jktightwad/PagerSystem/enclosure/ball_fit_test/hat_variant1.stl

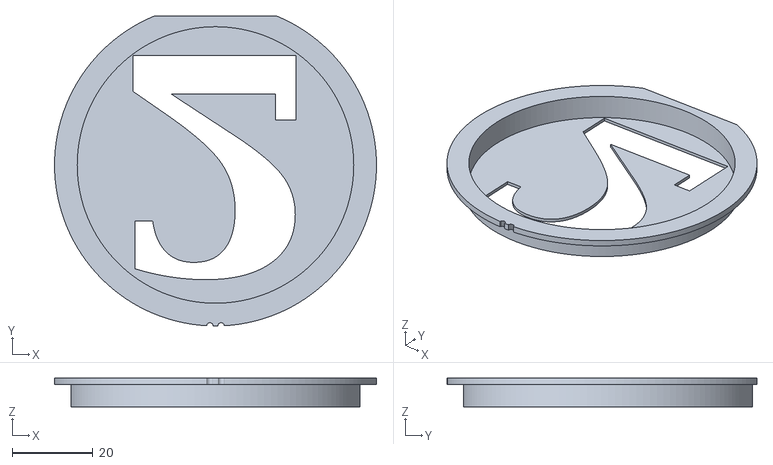
[picture p6: CAD file, 2026-11-08]
enclosure/ball_fit_test/hat_variant1.stl
80.0 x 77.0 x 7.10
