jktightwad/PagerSystem/enclosure/pager_rev2/pogo_test.stl

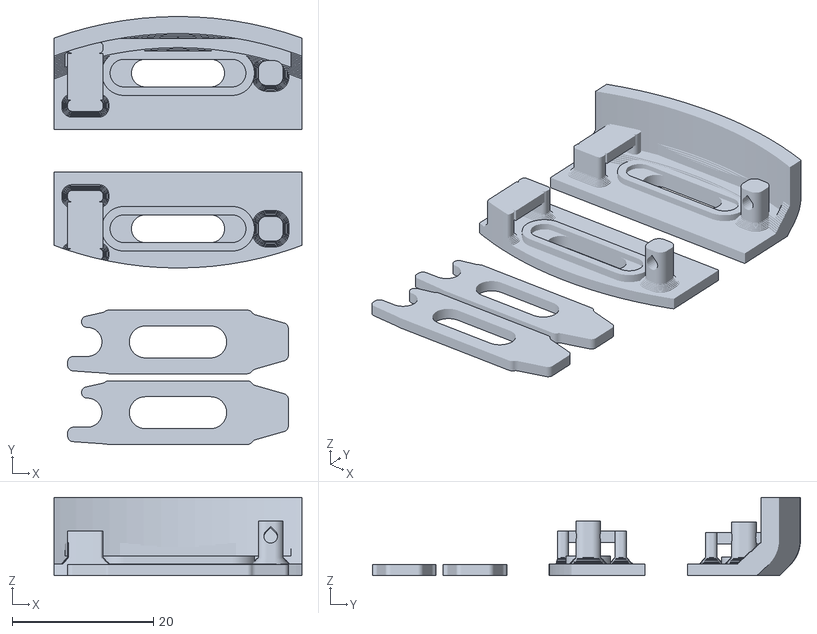
[picture p7: CAD file, 2026-11-14]
enclosure/pager_rev2/pogo_test.stl
35.0 x 60.5 x 11.1
