jktightwad/PagerSystem/enclosure/pager_shell_test/hat.stl

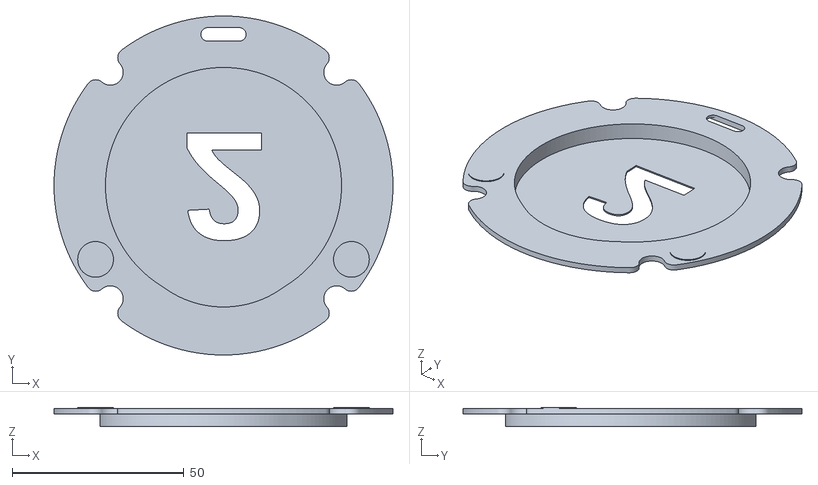
[picture p8: CAD file, 2026-11-13]
enclosure/pager_shell_test/hat.stl
98.7 x 98.7 x 5.55
