jktightwad/PagerSystem/enclosure/pogo_fit_test/pogo_fit_test.stl

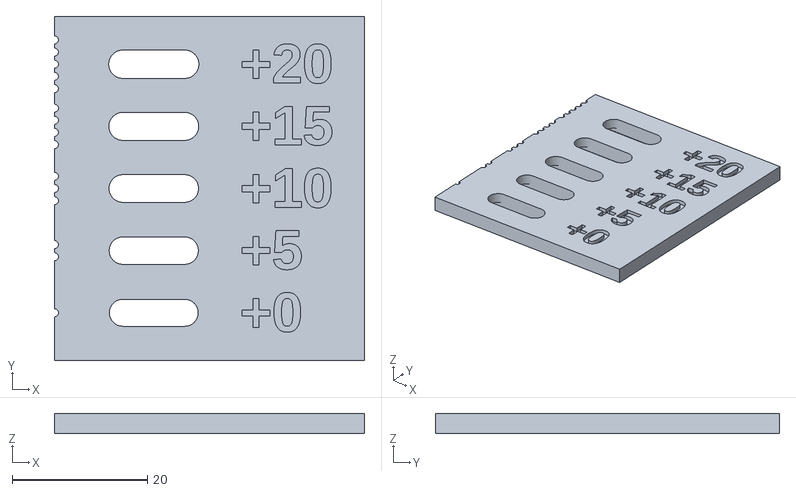
[picture p9: CAD file, 2026-11-09]
enclosure/pogo_fit_test/pogo_fit_test.stl
45.9 x 51.0 x 3.00
