jktightwad/PagerSystem/enclosure/pogo_key_test/pogo_key_top.stl

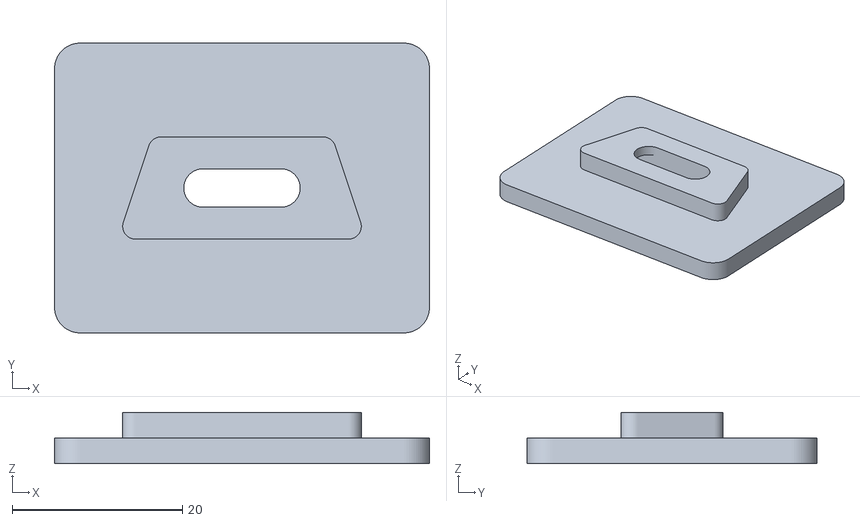
[picture p10: CAD file, 2026-11-08]
enclosure/pogo_key_test/pogo_key_top.stl
44.0 x 34.0 x 6.00
