jktightwad/PagerSystem/enclosure/ring_test/ring_test_spacers.stl

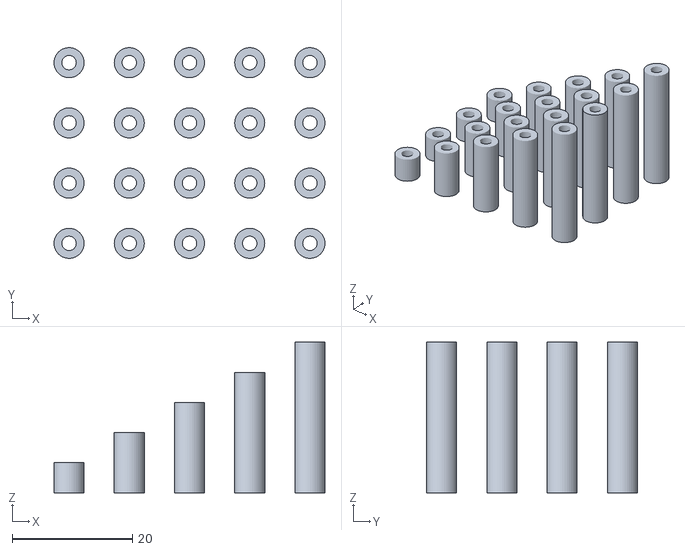
[picture p11: CAD file, 2026-11-08]
enclosure/ring_test/ring_test_spacers.stl
45.0 x 35.0 x 25.0
