jktightwad/PagerSystem/enclosure/pager_rev2/ball.stl

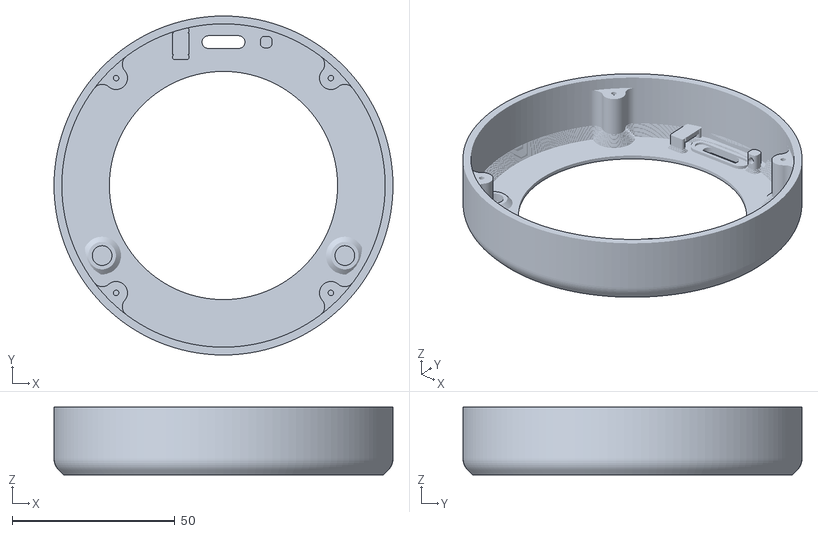
[picture p12: CAD file, 2026-11-14]
enclosure/pager_rev2/ball.stl
104.0 x 104.0 x 20.8
