jktightwad/PagerSystem/enclosure/pager_shell_test/chassis.stl

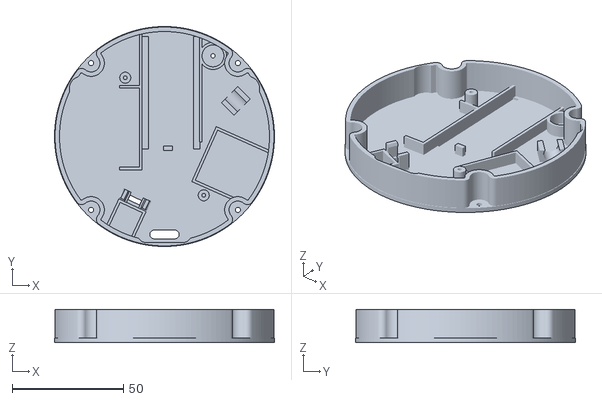
[picture p13: CAD file, 2026-11-13]
enclosure/pager_shell_test/chassis.stl
98.8 x 98.8 x 15.0
