jktightwad/PagerSystem/enclosure/ring_test/ring_test_base.stl

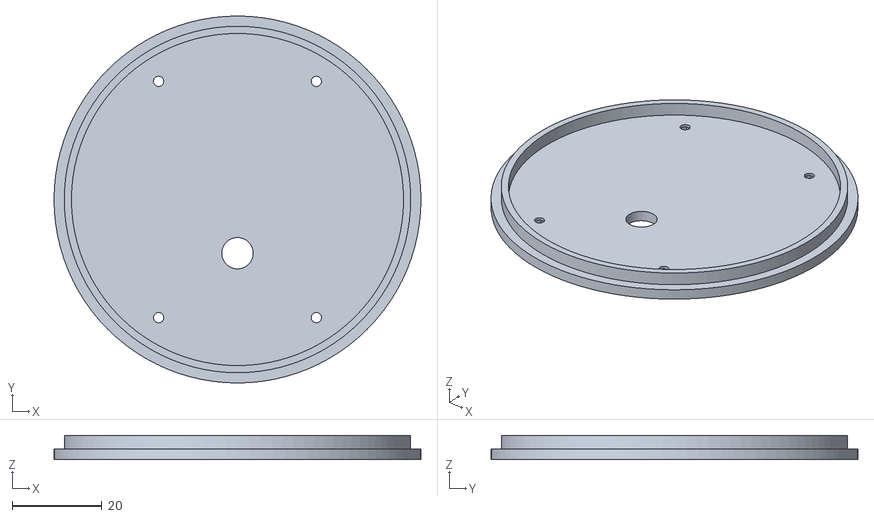
[picture p15: CAD file, 2026-11-08]
enclosure/ring_test/ring_test_base.stl
82.0 x 82.0 x 5.40
