jktightwad/PagerSystem/enclosure/ball_fit_test/clamp.stl

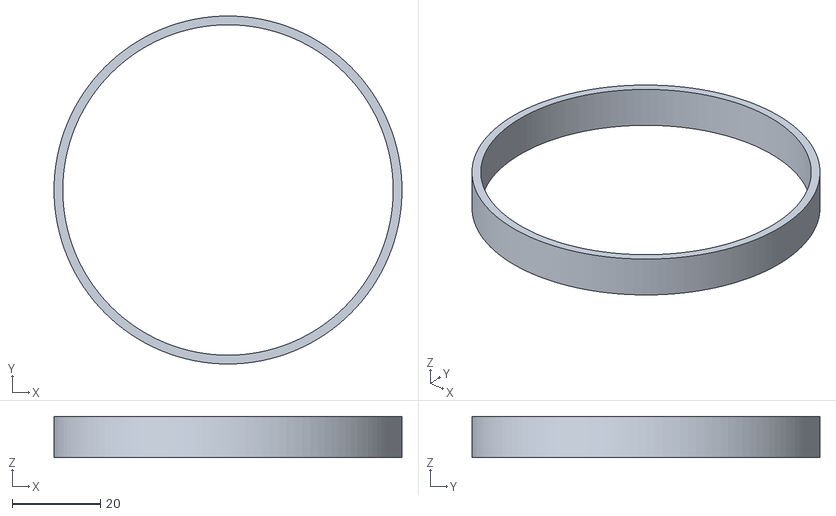
[picture p16: CAD file, 2026-11-08]
enclosure/ball_fit_test/clamp.stl
79.0 x 79.0 x 9.40
