jktightwad/PagerSystem/enclosure/pager_rev2/pogo_clamp.stl

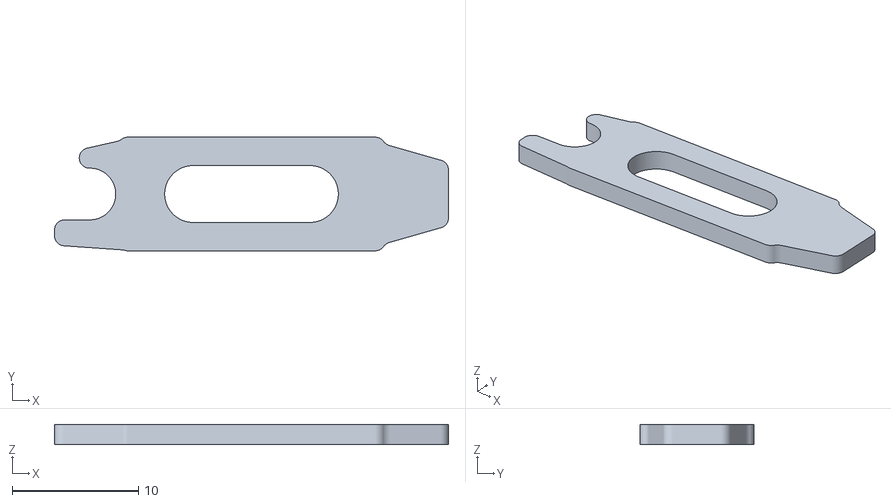
[picture p17: CAD file, 2026-11-14]
enclosure/pager_rev2/pogo_clamp.stl
31.2 x 9.00 x 1.60
