jktightwad/PagerSystem/enclosure/pager_shell_test/ball.stl

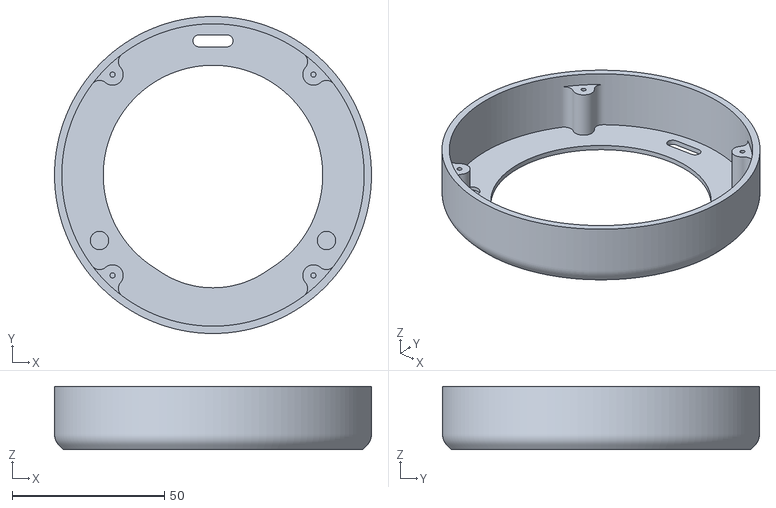
[picture p18: CAD file, 2026-11-13]
enclosure/pager_shell_test/ball.stl
104.0 x 104.0 x 20.8
