jktightwad/PagerSystem/enclosure/pogo_key_test/pogo_key_cal.stl

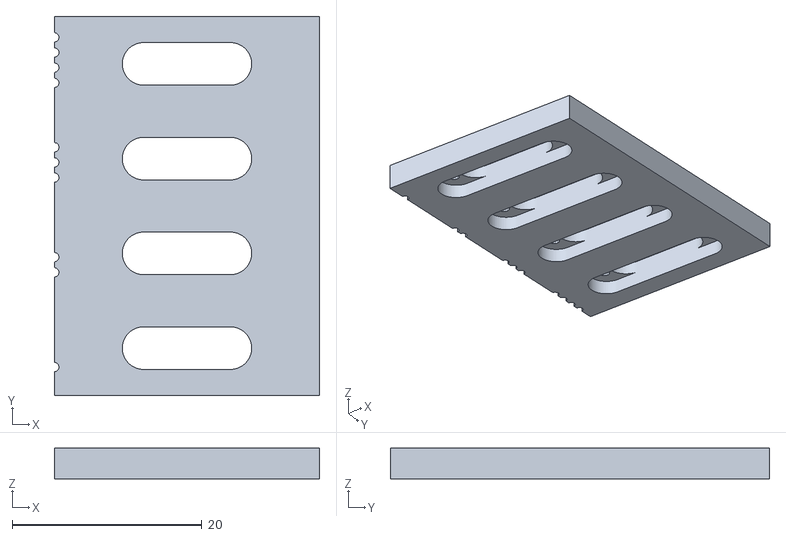
[picture p19: CAD file, 2026-11-08]
enclosure/pogo_key_test/pogo_key_cal.stl
28.0 x 40.0 x 3.25
