jktightwad/PagerSystem/enclosure/ring_test/ring_test_cup.stl

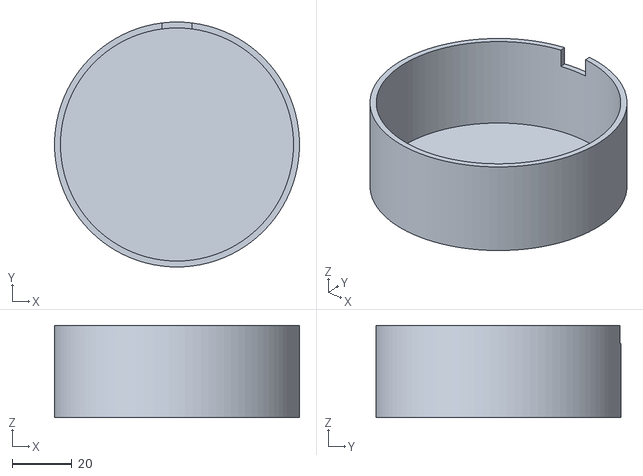
[picture p20: CAD file, 2026-11-08]
enclosure/ring_test/ring_test_cup.stl
82.0 x 82.0 x 30.8
