jktightwad/PagerSystem/enclosure/ball_fit_test/ball.stl

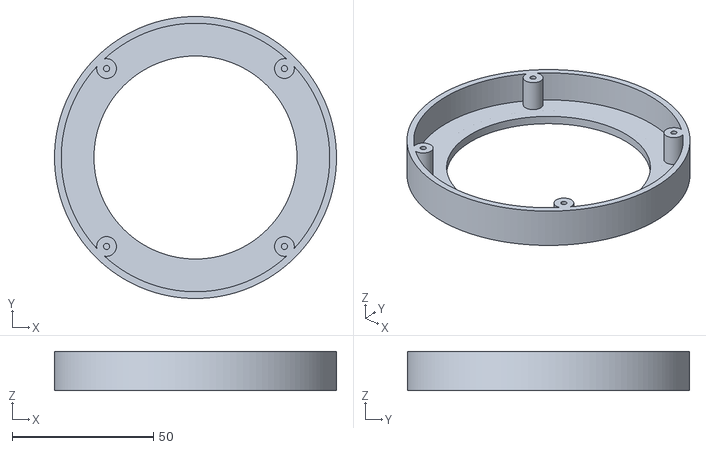
[picture p21: CAD file, 2026-11-08]
enclosure/ball_fit_test/ball.stl
100.0 x 100.0 x 14.0
