jktightwad/PagerSystem/enclosure/pager_rev2/base.stl

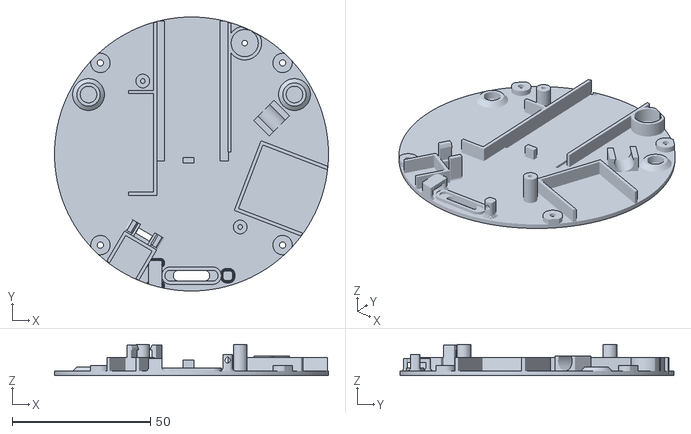
[picture p22: CAD file, 2026-11-14]
enclosure/pager_rev2/base.stl
99.1 x 99.1 x 11.3
