jktightwad/PagerSystem/enclosure/pager_shell_test/clip_test.stl

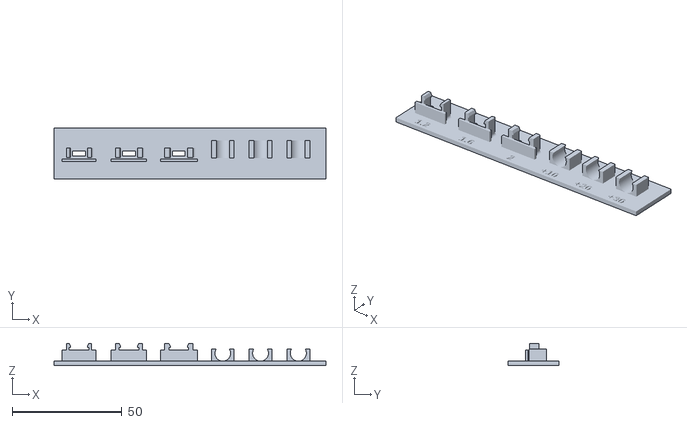
[picture p23: CAD file, 2026-11-13]
enclosure/pager_shell_test/clip_test.stl
123.8 x 23.0 x 10.1
