jktightwad/PagerSystem/enclosure/ball_fit_test/number.stl

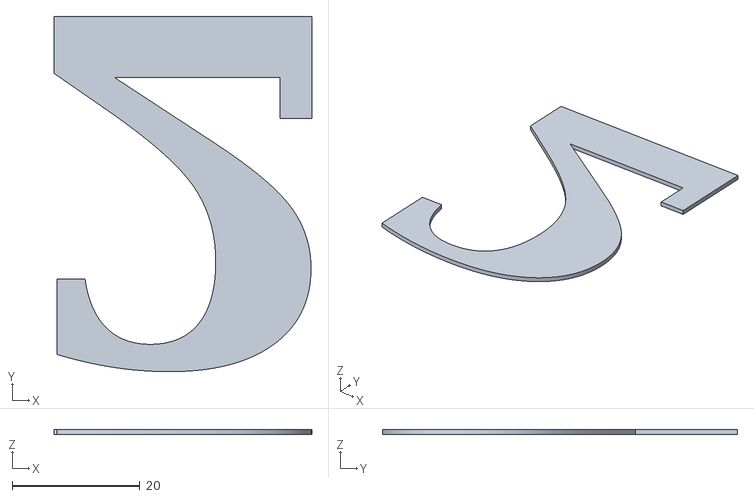
[picture p24: CAD file, 2026-11-08]
enclosure/ball_fit_test/number.stl
40.4 x 55.7 x 0.8
