jktightwad/PagerSystem/enclosure/pager_rev2/number.stl

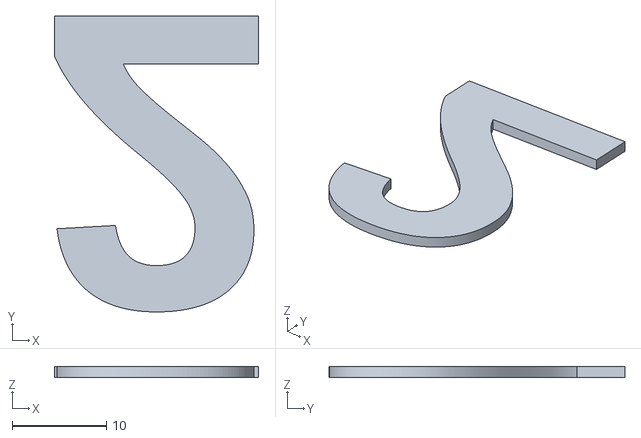
[picture p25: CAD file, 2026-11-14]
enclosure/pager_rev2/number.stl
21.7 x 31.4 x 1.21
