jktightwad/PagerSystem/enclosure/pager_shell_test/base.stl

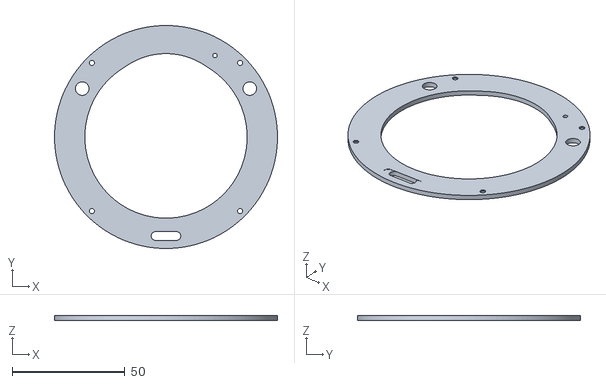
[picture p26: CAD file, 2026-11-13]
enclosure/pager_shell_test/base.stl
99.1 x 99.1 x 2.00
