jktightwad/PagerSystem/enclosure/ball_fit_test/base.stl

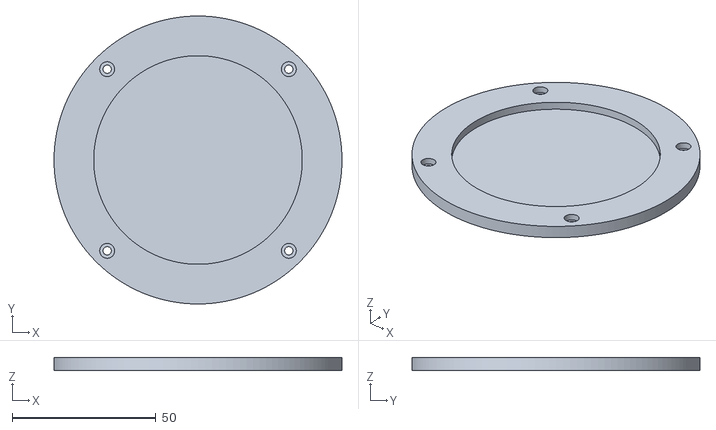
[picture p27: CAD file, 2026-11-08]
enclosure/ball_fit_test/base.stl
100.0 x 100.0 x 4.50
