jktightwad/PagerSystem/enclosure/pager_rev2/white.stl

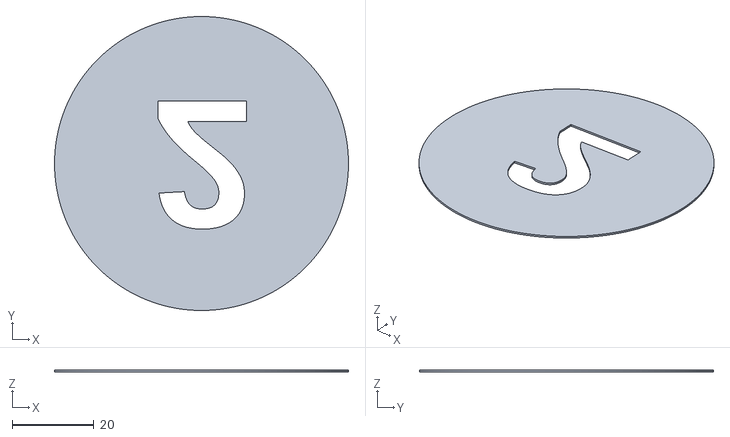
[picture p28: CAD file, 2026-11-14]
enclosure/pager_rev2/white.stl
72.0 x 72.0 x 0.46
