jktightwad/PagerSystem/enclosure/pager_shell_test/number.stl

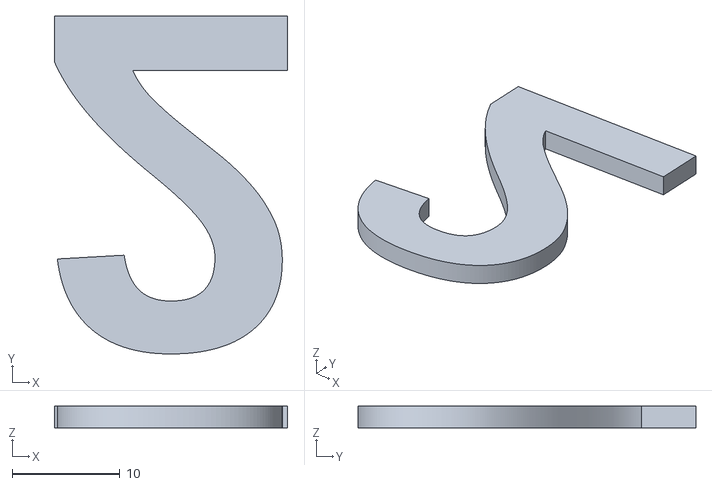
[picture p29: CAD file, 2026-11-10]
enclosure/pager_shell_test/number.stl
21.7 x 31.4 x 2.00
