jktightwad/PagerSystem/(list of files, cad)

Other CAD files:
enclosure/ball_fit_test/hat_variant2.stl
enclosure/ball_fit_test/hat_variant0.stl
