jktightwad/PagerSystem/(commit log)

2026-11-01 Add pager alert, PN5180 CSN and OTA test sketches; wiring and design updates
    - pager_alert_test: WS2812 ring, beeper, vibration, button, dock/battery
    - pn5180_csn_test: HID iCLASS CSN read (ACTALL/IDENTIFY/SELECT, no keys)
    - ota_test: base access point serving pager firmware, pager self-update
    - docs: pager wiring, OTA plan, touchscreen keyboard + rotary encoder,
    base pin budget question
    All sketches are written but not yet compiled or tested.
    Claude-Session: https://claude.ai/code/session_016rvrxpLKBnY1fDA5ftg5XD
    [ota_base.ino, ota_pager.ino, pager_alert_test.ino, pn5180_csn_test.ino]
2026-11-05 Add PlatformIO projects for each test; ESP32-C3 SuperMini support
    Pins that differ per board can now be set from platformio.ini build flags.
    Sketches remain uncompiled.
    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
2026-11-05 pn5180_csn_test: wait for USB serial, print pin config and BUSY state at startup
    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
2026-11-05 pn5180_csn_test: check SPI link at startup; clearer RF error message
    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
    [pn5180_csn_test.ino]
2026-11-05 pn5180_csn_test: verify SPI replies by reading EEPROM version bytes
    Catches a MISO fault, where commands work but every read returns zeros.
    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
2026-11-05 pn5180_csn_test: show actual pin numbers in SPI error messages
    Native-USB boards lose the startup lines when reset, so repeat them where
    they're needed.
    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
    [pn5180_csn_test.ino]
2026-11-05 pn5180_csn_test: print MISO bytes received during command phase
    The PN5180 should return FF while receiving a command; 00 points to MISO
    not being driven.
    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
2026-11-05 pn5180_csn_test: add GPIO loopback test ('l') to isolate MISO pin faults
    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
2026-11-05 pn5180_csn_test: optional custom SCK/MISO/MOSI pins via build flags
    Lets a damaged default SPI pin be worked around by rewiring and editing
    platformio.ini.
    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
    [pn5180_csn_test.ino]
2026-11-05 pn5180_csn_test: scan for the pin that actually sees the loopback HIGH
    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
2026-11-05 pn5180_csn_test: include sdkconfig.h so the C3 pin scan is not skipped
    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
    [pn5180_csn_test.ino]
2026-11-05 Record PN5180 iCLASS CSN read success; SPI troubleshooting notes
    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
2026-11-05 Range test: walker serves a live results page to a phone (no laptop)
    The walker runs a Wi-Fi hotspot on the ESP-NOW channel with a page showing
    live answered % and RSSI, a Record button per test spot, and CSV download.
    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
2026-11-05 Add VS Code workspace with every PlatformIO test project
    Open PagerSystem.code-workspace to have all test projects available and
    switch between them from PlatformIO's project picker.
    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
2026-11-05 range_walker: move web page into page.h to fix .ino prototype errors
    PlatformIO's .ino converter treated the page's JavaScript functions as C++
    prototypes. Also silence volatile compound-assignment warnings.
    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
    [range_walker.ino]
2026-11-05 Design: record POC range result and low-profile base antenna options
    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
2026-11-05 Pager: active buzzer default, PWM motor strength, coreless motor driver notes
    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
    [pager_alert_test.ino]
2026-11-05 Wiring: note the motor matches the customer-pager reference part
    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
2026-11-05 Wiring: LOLIN32 Lite has no 5V/BAT pins; charge via USB-C plug pigtail
    Battery + comes from the JST connector. Dock 5 V reaches the onboard
    charger through a short USB-C plug inside the pager.
    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
2026-11-05 pager_alert_test: beeper sweep for active buzzers, with reference beep
    'f' pulses the buzzer at a range of frequencies, replaying the plain on/off
    beep every few steps for comparison. ACTIVE_DRIVE_HZ selects a pulsed drive
    if one sounds louder.
    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
    [pager_alert_test.ino]
2026-11-05 Wiring: route battery through stripboard with JST pigtails (SMD connector)
    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
2026-11-08 Design: pool-ball enclosure, keyed stacking, docked glow, touch button behind number
    Test plan: docked glow, contact chain, touch ignored while docked, keying.
    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
2026-11-08 Design: measured 68.2 mm LED ring; pager ~90-100 mm; ring DI/DO wiring
    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
2026-11-08 Add LED ring diffusion test rig (OpenSCAD + STLs)
    Base with M2 nut traps, spacers for 5 gap heights, white 0.8 mm face cup.
    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
    [ring_test.scad, ring_test_base.stl, ring_test_cup.stl, ring_test_spacers.stl]
2026-11-08 Ring test rig: measured 2.0 mm holes and 2.5 mm ring height
    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
    [ring_test.scad, ring_test_base.stl, ring_test_cup.stl, ring_test_spacers.stl]
2026-11-08 Add pogo connector + keystone fit test coupons
    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
    [pogo_key_bottom.stl, pogo_key_test.scad, pogo_key_top.stl]
2026-11-08 Pogo coupons: measured 4 mm flange (rounded-end strip)
    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
    [pogo_key_bottom.stl, pogo_key_test.scad, pogo_key_top.stl]
2026-11-08 Add ball body + top-hat number insert fit test; record construction
    Clearances follow the user's 0.05 mm diameter PLA fit. Touch sensor moves
    to the underside stacking recess; pager number becomes a firmware setting.
    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
    [ball.stl, ball_fit_test.scad, base.stl, clamp.stl, hat_variant0.stl, hat_variant1.stl, hat_variant2.stl, number.stl]
2026-11-08 Pogo coupons: recess matches keystone height, flush faces, calibration chip
    First print left a >1 mm face gap: recess was 0.8 mm deeper than the
    keystone and faces sat below their surfaces. Recess is now keystone + 0.15,
    faces flush by default, and a 4-slot chip finds the right flange cover.
    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
    [pogo_key_bottom.stl, pogo_key_cal.stl, pogo_key_test.scad, pogo_key_top.stl]
2026-11-08 Add pager shell v2: egg key, lower crown, smaller number, flush pogo + clamp, magnets
    Supersedes ball_fit_test (v1) and the pogo keystone coupons.
    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
    [ball.stl, base.stl, brim_clamp.stl, hat.stl, number.stl, pager_shell_test.scad, pogo_clamp.stl]
2026-11-08 pager_shell_test: Customizer groups and dropdowns
    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
    [pager_shell_test.scad]
2026-11-08 Shell: number inlay 2.4 mm deep (0.8 face + 1.6 behind) so it doesn't glow
    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
    [hat.stl, number.stl, pager_shell_test.scad]
2026-11-08 Pager light states: red dock/charge gauge, blue confirm/ack, green your turn
    pager_alert_test now demonstrates the scheme (d/u/k/a/s); design and test
    plan updated.
    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
2026-11-08 Shell: tighter stacking fit (0.2 mm) with lead-in chamfers on recess and crown
    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
    [base.stl, hat.stl, pager_shell_test.scad]
2026-11-08 Shell v3: brim ears over columns, chassis plate (brim/pogo clamps, LED posts), rounded edge
    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
    [ball.stl, base.stl, brim_clamp.stl, chassis.stl, hat.stl, pager_shell_test.scad, pogo_clamp.stl]
2026-11-08 Shell v4: filleted columns, full-interior hat brim (holds pogo + magnets), outer clamp ring, egg_tip 2 mm
    egg_shift 5 would have produced a round egg; replaced by egg_tip (how far
    the narrow end sticks out).
    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
    [ball.stl, base.stl, chassis.stl, hat.stl, pager_shell_test.scad]
2026-11-08 Shell v5: base sits flush inside the ball wall; centre wire holes removed
    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
    [ball.stl, base.stl, chassis.stl, pager_shell_test.scad]
2026-11-09 Shell v6: sunk 1 mm brim, base ring + chassis recess ceiling, clamp ring relief
    Recovers ~2.6 mm of inside height and stops the base standing proud.
    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
    [ball.stl, base.stl, chassis.stl, hat.stl, pager_shell_test.scad]
2026-11-09 Shell v7: internal_h drives ball height; M2x8 shell screws, M2x6 LED screws; egg_tip 1, recess fit 0.1
    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
    [ball.stl, base.stl, chassis.stl, hat.stl, pager_shell_test.scad]
2026-11-09 Shell: flange pocket length/width as editable Customizer values
    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
    [ball.stl, base.stl, chassis.stl, hat.stl, pager_shell_test.scad]
2026-11-09 Add generic connector fit tester (defaults: original measured pogo connector)
    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
    [pogo_fit_test.scad, pogo_fit_test.stl]
2026-11-09 Fit tester: labels handle negative clearances; note on testing tighter holes
    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
    [pogo_fit_test.scad, pogo_fit_test.stl]
2026-11-09 Fit tester: large hundredths labels + edge notches; 0.01 mm Customizer steps (tester and shell)
    Customizer read 4.0 as an integer and stepped in whole mm; explicit ranges
    fix that.
    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
    [pager_shell_test.scad, pogo_fit_test.scad, pogo_fit_test.stl]
2026-11-09 Shell v8: hat split into crown + brim (no supports), fit-test connector sizes, export-all scripts
    Crown has a 45-deg lip holding a press-fit brim; brim prints flat. Pressers
    follow the connector depth automatically. export_all.bat/.sh write every
    part as its own STL.
    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
    [ball.stl, base.stl, brim.stl, chassis.stl, crown.stl, hat.stl, pager_shell_test.scad]
2026-11-09 Revert hat split: hat is one piece again
    Keeps the fit-test connector sizes, the automatic flange pressers and the
    export-all scripts.
    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
    [ball.stl, base.stl, brim.stl, chassis.stl, crown.stl, hat.stl, pager_shell_test.scad]
2026-11-09 Shell v9: 2 mm face, internal_h 4, light_t control, led_depth, no chamfers, more base pogo room
    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
    [ball.stl, base.stl, chassis.stl, hat.stl, pager_shell_test.scad]
2026-11-09 pn5180_csn_test: add esp32c3_supermini_alt_spi env (MISO 0, MOSI 1)
    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
2026-11-09 Shell v10: brim_t = brim thickness, brim_sink = pocket depth; pockets cut to part depth with caps/tongue only where needed
    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
    [ball.stl, base.stl, chassis.stl, hat.stl, pager_shell_test.scad]
2026-11-09 Shell: cap_wall (2 mm) around magnet pockets, clamp ring notched for caps; mag_pocket_d setting
    Caps had a fixed 0.4 mm wall and sheared off.
    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
    [ball.stl, base.stl, chassis.stl, hat.stl, pager_shell_test.scad]
2026-11-09 Shell: bundle the number font with the model; number_scale setting
    A missing system font is silently replaced by OpenSCAD, which changed the
    digit's size on other PCs. DejaVu fonts are freely redistributable (license
    included).
    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
    [ball.stl, base.stl, chassis.stl, hat.stl, pager_shell_test.scad]
2026-11-09 Shell: automatic underline for 6 and 9 (part of the number inlay)
    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
    [ball.stl, base.stl, chassis.stl, hat.stl, pager_shell_test.scad]
2026-11-09 Shell: Liberation Sans Bold number font (bundled), curved pool-ball underline for 6 and 9
    Underline sizes scale with the number; digit_h_ratio places it per font.
    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
    [ball.stl, base.stl, chassis.stl, hat.stl, number.stl, pager_shell_test.scad]
2026-11-09 Shell: underline closer to the number (gap 0.025 x number height)
    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
    [ball.stl, base.stl, chassis.stl, hat.stl, pager_shell_test.scad]
2026-11-09 Shell: number_scale 0.45, underline sag 0.06; export_numbers scripts for hats/numbers 1-15
    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
    [ball.stl, base.stl, chassis.stl, hat.stl, number.stl, pager_shell_test.scad]
2026-11-10 Add chassis component layout sketch
    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
    [layout_sketch.scad]
2026-11-10 Keep ball 20.8 mm: LED ring raised (led_depth 2.6), internal_h 8.2, crown wall 1.2; battery under LOLIN in layout
    Space under the LED ring goes from 9 to 13.2 mm for battery + LOLIN32.
    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
    [ball.stl, base.stl, chassis.stl, hat.stl, layout_sketch.scad, pager_shell_test.scad]
2026-11-10 Layout: LOLIN32 middle (far from pogo), battery/boost/buzzer left, motor U-clips right; chassis channels, clips, sound hole; power plan
    LED ring back at its original height (led_depth 6.8, internal_h 4, crown
    wall 1.6).
    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
    [ball.stl, base.stl, chassis.stl, hat.stl, layout_sketch.scad, pager_shell_test.scad]
2026-11-10 Chassis: general component layout with 1.2 mm pockets (not final)
    Battery stand-in pocket sharing a wall with the LOLIN32 (shifted right),
    boost at ~7 o'clock against the wall, buzzer at ~6:30 inside the LED ring
    with one sound hole, touch module at ~4 o'clock facing the centre, motor
    U-clips at ~3 o'clock angled 45 deg toward the LOLIN32. LED ring posts at
    1 and 7 o'clock removed. All positions are Customizer settings.
    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
    [ball.stl, base.stl, chassis.stl, hat.stl, pager_shell_test.scad]
2026-11-10 Chassis layout: 5 mm pocket walls, no back wall on wall-side pockets
    Boost and touch pockets now use the clamp-ring wall as their back wall;
    their radius is computed so the part touches it (boost_gap / touch_gap
    move it in). Pocket walls are trimmed to the inside of the ring/columns.
    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
    [ball.stl, base.stl, chassis.stl, hat.stl, pager_shell_test.scad]
2026-11-10 Chassis layout: touch module 24 x 24.3, motor moved up to clear it
    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
    [ball.stl, base.stl, chassis.stl, hat.stl, pager_shell_test.scad]
2026-11-10 Chassis layout: drop pocket walls on the chassis-wall side
    Battery pocket open on the left, LOLIN32 pocket open at the 12 o'clock end;
    clamp ring cut away behind the boost and touch module (ring_open_at_parts).
    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
    [ball.stl, base.stl, chassis.stl, hat.stl, pager_shell_test.scad]
2026-11-10 Chassis: keep clamp ring by default; add chassis.step for CAD editing
    STEP converted from the STL with OpenCascade (sewn, coplanar faces merged);
    curved surfaces stay faceted.
    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
    [ball.stl, base.stl, chassis.step, chassis.stl, hat.stl, pager_shell_test.scad]
2026-11-10 Chassis layout: battery at 9 o'clock with 3 walls + clamp ring
    Battery (503035), boost and touch module pockets are 3-sided with the clamp
    ring as the 4th wall; LOLIN32 moved to share the battery's inner wall.
    chassis.step regenerated.
    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
    [ball.stl, base.stl, chassis.step, chassis.stl, hat.stl, pager_shell_test.scad]
2026-11-10 Shell v11: 0.4 lit face, 2.6 ball face, r5 edge, ring 1 mm lower; chassis tweaks
    Touch module rotated 3 deg CCW to clear the column; LOLIN32 tray walls 4 mm
    shorter at the pogo end with a stop tab. Remove chassis.step (no longer needed).
    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
    [ball.stl, base.stl, chassis.step, chassis.stl, hat.stl, number.stl, pager_shell_test.scad]
2026-11-10 Remove chassis.step; README v11 notes
    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
    [chassis.step]
2026-11-10 Shell v12: switch mount, single motor clip, snug LOLIN32 tray, clip test plate
    - one 8 mm motor clip with +0.2 mm bore clearance
    - LOLIN32 tray 0.05 mm per side, top end on the clamp ring, 4 mm stop tab
    - battery 4 mm towards 12 o'clock; buzzer on the wall by the 7:30 column
    - power switch mount (riser pads, end clips, slider slot in plate + base)
    - clip_test part for the switch mount and motor clip clearances
    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
    [ball.stl, base.stl, chassis.stl, clip_test.stl, hat.stl, pager_shell_test.scad]
2026-11-10 Shell v13: switch mount fixes and new position; motor clip +0.1
    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
    [ball.stl, base.stl, chassis.stl, clip_test.stl, hat.stl, pager_shell_test.scad]
2026-11-10 Switch wall: span the clips so it doesn't meet them only at an edge (fixes non-manifold export)
    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
    [chassis.stl, clip_test.stl, pager_shell_test.scad]
2026-11-10 Switch wall: 0.6 mm clear of each clip, 1.5 mm lower, so the clips can flex
    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
    [chassis.stl, clip_test.stl, pager_shell_test.scad]
2026-11-11 Shell v14: stronger switch hooks; switch backed by the boost pocket wall
    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
    [ball.stl, base.stl, chassis.stl, clip_test.stl, hat.stl, pager_shell_test.scad]
2026-11-11 Shell v15: switch clip arms 2.4 mm, pads no longer fused to the arms; test plate with 3 arm thicknesses
    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
    [ball.stl, base.stl, chassis.stl, clip_test.stl, hat.stl, pager_shell_test.scad]
2026-11-11 Switch clip arms back to 1.2 mm (tested fine with the pads separated)
    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
    [ball.stl, base.stl, chassis.stl, clip_test.stl, hat.stl, pager_shell_test.scad]
2026-11-11 Switch: 0.4 mm pad-to-clip gap; echo/assert the riser pad height (slider length - plate)
    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
    [ball.stl, base.stl, chassis.stl, clip_test.stl, hat.stl, pager_shell_test.scad]
2026-11-11 Shell v16: coved 1.6 mm switch clips, thicker motor clip, tighter LOLIN32 tray
    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
    [ball.stl, base.stl, chassis.stl, clip_test.stl, hat.stl, pager_shell_test.scad]
2026-11-12 Hat: brim_sag_comp 0.3 mm to offset the supported brim face sagging
    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
    [hat.stl, pager_shell_test.scad]
2026-11-12 Base: add the buzzer sound hole
    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
    [base.stl, pager_shell_test.scad]
2026-11-13 Shell v18: buzzer beside the LOLIN32's back end; battery walls cut to 9 mm stubs
    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
    [ball.stl, base.stl, chassis.stl, clip_test.stl, hat.stl, pager_shell_test.scad]
2026-11-13 Alert test: touch module on GPIO 33 (active-high option); wiring doc
    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
2026-11-13 Shell v19: hat protrudes 1.7 mm, ball height unchanged (internal_h 3.2)
    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
    [ball.stl, base.stl, chassis.stl, clip_test.stl, hat.stl, pager_shell_test.scad]
2026-11-14 Add enclosure Rev 2: flat 3-colour ball top, base carries the components
    Ball (top down, AMS: ball/white/number parts) with a 0.45 mm white over a
    light pocket, 1.2 mm deep number, corner build-up; magnets inserted from
    inside; pogo connectors held by a pinned clamp in printed forks. Base is a
    1.65 mm plate with the Rev 1 chassis mounts. Rev 1 left unchanged.
    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
    [ball.stl, base.stl, number.stl, pager_rev2.scad, pogo_clamp.stl, white.stl]
2026-11-14 Rev 2: magnets back at 60/300 deg (alignment triangle with the pogo); motor moved to clear
    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
    [ball.stl, base.stl, pager_rev2.scad]
2026-11-14 Rev 2: hill-shaped magnet bosses; pogo clamp latch + single pin with 3.5 mm legs
    Pogo moved in to r 42.5 so the legs fit; clamp ends 4 mm; boost 211.3 deg.
    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
    [ball.stl, base.stl, pager_rev2.scad, pogo_clamp.stl]
2026-11-14 Rev 2: 0.1 mm room under the pogo latch bar
    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
    [ball.stl, base.stl, pager_rev2.scad]
2026-11-14 Rev 2: pogo clamp pinned at a single post (forked clamp end); pogo back to r 44
    Pin hole 1.8 mm; latch legs 1.6 mm; clamp ends 5 mm; boost 210.5 deg.
    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
    [ball.stl, base.stl, pager_rev2.scad, pogo_clamp.stl]
2026-11-14 Rev 2: smoothed pogo clamp (rounded, filleted, tapered fork) and flared, rounded post/legs
    Clamp widened to 7 mm so the rails beside the wire hole are 1.25 mm.
    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
    [ball.stl, base.stl, pager_rev2.scad, pogo_clamp.stl]
2026-11-14 Rev 2: pogo latch test print (pogo_test)
    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
    [base.stl, pager_rev2.scad, pogo_test.stl]
2026-11-14 Rev 2 pogo clamp: 5 mm tongue, thin wall-side tine, wider body, 1.95 pin hole
    Latch window 1 mm narrower on the wall side; clamp body +2 mm on the centre
    side; corner build-up cut back round the clamp so the top clamp fits.
    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
    [ball.stl, base.stl, pager_rev2.scad, pogo_clamp.stl, pogo_test.stl]
2026-11-14 Rev 2 pogo clamp: body widened 1 mm each side (symmetric 9 mm)
    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
    [ball.stl, pager_rev2.scad, pogo_clamp.stl, pogo_test.stl]
